amberrabithole/SoundCard_interface/SC_interface/SC_interface.kicad_pcb

## KiCad design SC_interface/SC_interface.kicad_pcb (2026-10-28)

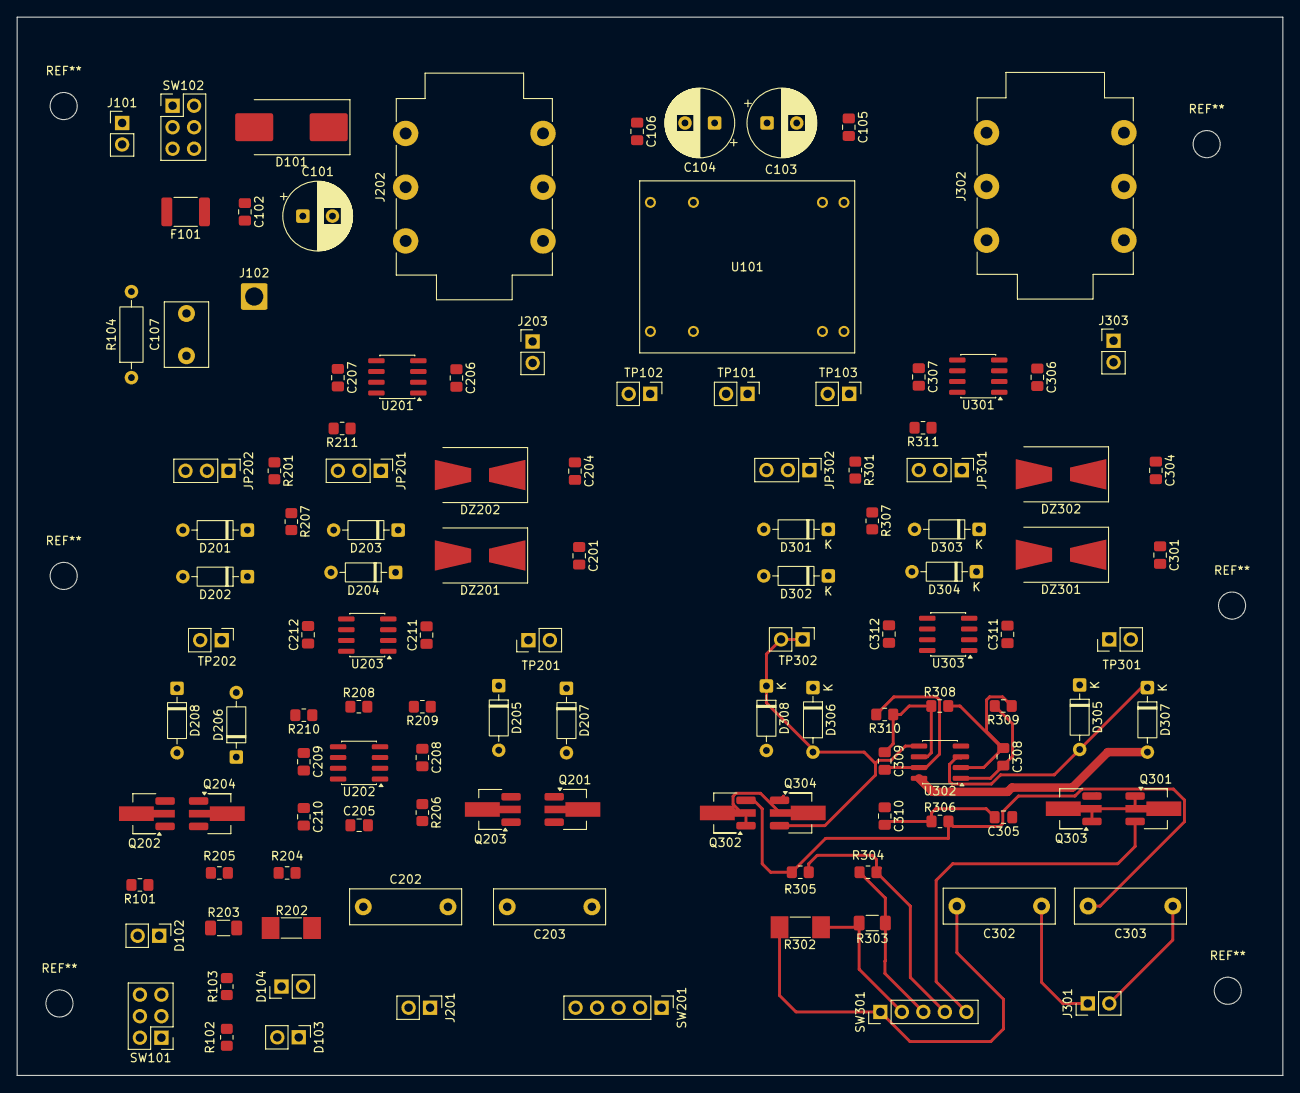
[picture p4: board SC_interface.kicad_pcb from above]

Board: 2 copper layers, 149.5 x 125.0 mm, 120 parts (0 on the bottom side), 65 nets.

Parts:
C101, C103, C104: 330uf 25V; CP_Radial_D8.0mm_P3.50mm
C102, C105, C106, C201, C204, C205, C206, C207, C210, C211, C212, C301, C304, C305, C306, C307, C310, C311, C312: 0.1uf; C_0805_2012Metric_Pad1.18x1.45mm_HandSolder
C107: 10nF 1kV; C_Disc_D7.5mm_W5.0mm_P5.00mm
C202, C203, C302, C303: 0.47uf 400V; C_Rect_L13.0mm_W4.0mm_P10.00mm_FKS3_FKP3_MKS4
C208, C209, C308, C309: 15pF; C_0805_2012Metric_Pad1.18x1.45mm_HandSolder
D101: SMCJ6.0A; D_SMC_Handsoldering
D102: M_PWR; PinHeader_1x02_P2.54mm_Vertical
D103: PWR_PS; PinHeader_1x02_P2.54mm_Vertical
D104: PWR_NEG; PinHeader_1x02_P2.54mm_Vertical
D201, D202, D203, D204, D205, D206, D207, D208, D301, D302, D303, D304, D305, D306, D307, D308: 1N4148; D_DO-35_SOD27_P7.62mm_Horizontal
DZ201, DZ202, DZ301, DZ302: 1SMB5917; D_SMB-SMC_Universal_Handsoldering
F101: MF-MSMF110; Fuse_1812_4532Metric_Pad1.30x3.40mm_HandSolder
J101: 5V_PWR; PinHeader_1x02_P2.54mm_Vertical
J102: J_chassis; SolderWire-1.5sqmm_1x01_D1.7mm_OD3mm
J201, J301: Input; PinHeader_1x02_P2.54mm_Vertical
J202, J302: BalancedOut; Jack_6.35mm_Neutrik_NMJ6HCD2_Horizontal
J203, J303: Output_BNC; PinHeader_1x02_P2.54mm_Vertical
JP201, JP301: Clamp1; PinHeader_1x03_P2.54mm_Vertical
JP202, JP302: Clamp2; PinHeader_1x03_P2.54mm_Vertical
Q201, Q202, Q203, Q204, Q301, Q302, Q303, Q304: LND150N8; SOT-89-3_Handsoldering
R101: 470R; R_0805_2012Metric_Pad1.20x1.40mm_HandSolder
R102, R103: 3K; R_0805_2012Metric_Pad1.20x1.40mm_HandSolder
R104: 1M, 1W; R_Axial_DIN0207_L6.3mm_D2.5mm_P10.16mm_Horizontal
R201, R207, R301, R307: 1k; R_0805_2012Metric_Pad1.20x1.40mm_HandSolder
R202, R302: 90.9k; R_MELF_MMB-0207
R203, R303: 9.09k; R_1206_3216Metric_Pad1.30x1.75mm_HandSolder
R204, R304: 909; R_0805_2012Metric_Pad1.20x1.40mm_HandSolder
R205, R305: 102; R_0805_2012Metric_Pad1.20x1.40mm_HandSolder
R206, R306: 100k; R_0805_2012Metric_Pad1.20x1.40mm_HandSolder
R208, R308: 10k; R_0805_2012Metric_Pad1.20x1.40mm_HandSolder
R209, R210, R309, R310: 7.5k; R_0805_2012Metric_Pad1.20x1.40mm_HandSolder
R211, R311: 200R; R_0805_2012Metric_Pad1.20x1.40mm_HandSolder
SW101: Main Power; PinHeader_2x03_P2.54mm_Vertical
SW102: Master SW; PinHeader_2x03_P2.54mm_Vertical
SW201, SW301: SW_Select1; PinHeader_1x05_P2.54mm_Vertical
TP101: TP_POS; PinHeader_1x02_P2.54mm_Vertical
TP102: TP_NEG; PinHeader_1x02_P2.54mm_Vertical
TP103: TP_GND; PinHeader_1x02_P2.54mm_Vertical
TP201, TP301: TP_IN_HOT; PinHeader_1x02_P2.54mm_Vertical
TP202, TP302: TP_IN_COLD; PinHeader_1x02_P2.54mm_Vertical
U101: JCA0305D03; XPDCDCCONV
U201, U301: DRV135UA; SOIC-8_3.9x4.9mm_P1.27mm
U202, U302: U2 OPA1656IDR; SOIC-8_3.9x4.9mm_P1.27mm
U203, U303: INA134UA; SOIC-8_3.9x4.9mm_P1.27mm

Connections:
+VDC: C205.1, C207.1, C212.1, C305.1, C307.1, C312.1, D207.2 (A), D208.2 (A), D307.2 (A), D308.2 (A), R102.1, R201.2, R301.2, SW101.3 (C), TP101.1, TP101.2, U201.6 (V+), U202.8 (V+), U203.7 (V+), U301.6 (V+), U302.8 (V+), U303.7 (V+)
-VDC: C206.2, C210.1, C211.1, C306.2, C310.1, C311.1, D205.1 (K), D206.1 (K), D305.1 (K), D306.1 (K), R103.1, R207.1, R307.1, SW101.6 (C), TP102.1, TP102.2, U201.5 (V-), U202.4 (V-), U203.4 (V-), U301.5 (V-), U302.4 (V-), U303.4 (V-)
/5V_in: J101.1, SW102.2 (B), SW102.5 (B)
/GNDREF: C101.2, C102.2, D101.2 (A), D102.1 (K), J101.2, U101.2 (-VIN), U101.3 (-VIN2)
/Input_ChannelL/SCPROT: D201.1 (K), D203.2 (A), J203.1 (In), R211.2, U201.4 (VIN)
/Input_ChannelL/VOut_neg: J202.R, U201.1 (-VO), U201.2 (-SENSE)
/Input_ChannelL/VOut_pos: J202.T, U201.7 (+SENSE), U201.8 (+VO)
/Input_ChannelR/SCPROT: D301.1 (K), D303.2 (A), J303.1 (In), R311.2, U301.4 (VIN)
/Input_ChannelR/VOut_neg: J302.R, U301.1 (-VO), U301.2 (-SENSE)
/Input_ChannelR/VOut_pos: J302.T, U301.7 (+SENSE), U301.8 (+VO)
GND: C103.2, C104.1, C105.2, C106.2, C107.2, C201.1, C204.1, C205.2, C206.1, C207.2, C210.2, C211.2, C212.2, C301.1, C304.1, C305.2, C306.1, C307.2, C310.2, C311.2, C312.2, D103.1 (K), D104.2 (A), D202.2 (A), D204.1 (K), D302.2 (A), D304.1 (K), DZ201.2 (A), DZ202.1 (K), DZ301.2 (A), DZ302.1 (K), J202.S, J203.2 (Ext), J302.S, J303.2 (Ext), R104.2, R206.1, R306.1, TP103.1, TP103.2, U101.9 (COMMON), U101.16 (COMMON2), U201.3 (GND), U203.1 (REF), U301.3 (GND), U303.1 (REF)
unnamed: C202.2, R202.2, SW201.1
unnamed: C302.2, R302.2, SW301.1
unnamed: C101.1, C102.1, D101.1 (K), F101.2, R101.1, U101.22 (+VIN), U101.23 (+VIN2)
unnamed: D102.2 (A), R101.2
unnamed: D103.2 (A), R102.2
unnamed: D104.1 (K), R103.2
unnamed: D201.2 (A), JP201.2 (C), R201.1
unnamed: D202.1 (K), JP201.1 (A)
unnamed: D203.1 (K), JP202.2 (C), R207.2
unnamed: D204.2 (A), JP202.1 (A)
unnamed: D205.2 (A), D207.1 (K), Q203.3 (D), TP201.1, TP201.2, U202.3 (+)
unnamed: D206.2 (A), D208.1 (K), Q204.3 (D), TP202.1, TP202.2, U202.5 (+)
unnamed: D301.2 (A), JP301.2 (C), R301.1
unnamed: D302.1 (K), JP301.1 (A)
unnamed: D303.1 (K), JP302.2 (C), R307.2
unnamed: D304.2 (A), JP302.1 (A)
unnamed: D305.2 (A), D307.1 (K), Q303.3 (D), TP301.1, TP301.2, U302.3 (+)
unnamed: D306.2 (A), D308.1 (K), Q304.3 (D), TP302.1, TP302.2, U302.5 (+)
unnamed: C201.2, DZ201.1 (K), JP201.3 (B)
unnamed: C204.2, DZ202.2 (A), JP202.3 (B)
unnamed: C301.2, DZ301.1 (K), JP301.3 (B)
unnamed: C304.2, DZ302.2 (A), JP302.3 (B)
unnamed: C107.1, J102.1 (Pin_1_1), R104.1
unnamed: C203.1, J201.2 (Ext)
unnamed: C202.1, J201.1 (In)
unnamed: C303.1, J301.2 (Ext)
unnamed: C302.1, J301.1 (In)
unnamed: Q201.3 (D), SW201.5
unnamed: Q201.1 (G), Q201.2 (S), Q203.1 (G), Q203.2 (S)
unnamed: C203.2, Q202.3 (D), R205.1, R206.2
unnamed: Q202.1 (G), Q202.2 (S), Q204.1 (G), Q204.2 (S)
unnamed: Q301.3 (D), SW301.5
unnamed: Q301.1 (G), Q301.2 (S), Q303.1 (G), Q303.2 (S)
unnamed: C303.2, Q302.3 (D), R305.1, R306.2
unnamed: Q302.1 (G), Q302.2 (S), Q304.1 (G), Q304.2 (S)
unnamed: R202.1, R203.2, SW201.2
unnamed: R203.1, R204.2, SW201.3
unnamed: R204.1, R205.2, SW201.4
unnamed: R302.1, R303.2, SW301.2
unnamed: R303.1, R304.2, SW301.3
unnamed: R304.1, R305.2, SW301.4
unnamed: C103.1, C105.1, SW101.2 (B), U101.14 (+VOUT)
unnamed: C104.2, C106.1, SW101.5 (B), U101.11 (-VOUT)
unnamed: F101.1, SW102.3 (C), SW102.6 (C)
unnamed: C208.1, R208.2, R209.1, U202.2 (-)
unnamed: C209.1, R208.1, R210.1, U202.6 (-)
unnamed: C208.2, R209.2, U202.1, U203.3 (IN+)
unnamed: C209.2, R210.2, U202.7, U203.2 (IN-)
unnamed: R211.1, U203.5 (SENSE), U203.6 (OUT)
unnamed: C308.1, R308.2, R309.1, U302.2 (-)
unnamed: C309.1, R308.1, R310.1, U302.6 (-)
unnamed: C308.2, R309.2, U302.1, U303.3 (IN+)
unnamed: C309.2, R310.2, U302.7, U303.2 (IN-)
unnamed: R311.1, U303.5 (SENSE), U303.6 (OUT)
