amberrabithole/SoundCard_interface/(commit log)

2026-10-24 updated desgin doc, draw draft of the schematic
    V1 circuit
2026-10-25 completed Channel 1
    completed two opamps
    completed clamping network
2026-10-26 schemetic change and initial 3D rendering
    Added master switch, some LED, Test Point.
    Fixed all the footprint issues, passed ECE check
    Initial 3D rendering the PCB update
2026-10-28 schematic changes
    1. added TVS at output of DC-DC convert to prevent kick back
    2. Changed all diodes to BAV199
    3. change the Cfeedback to 4.7uF
    4. removed LND Fet, replaced it with 4.7 K ohm
2026-10-30 design doc updated
    1. 2.5mHz update.
    C feedback. input stage change, clamping diodes,
    rotary switch and R ladder, wire selection
    Removed LND in favor of using 4.7 K fuseable R
    Power supply switch, kick back TVS,
2026-10-31 change the R ladder and switch to pin head
